PUT-Motorsport/PUTM_EV_Frontbox_2024_Hardware/Hardware/PUTM_EV_Frontbox_2023/PUTM_EV_Frontbox_2023.kicad_pcb

## KiCad design Hardware/PUTM_EV_Frontbox_2023/PUTM_EV_Frontbox_2023.kicad_pcb (2024-03-22)

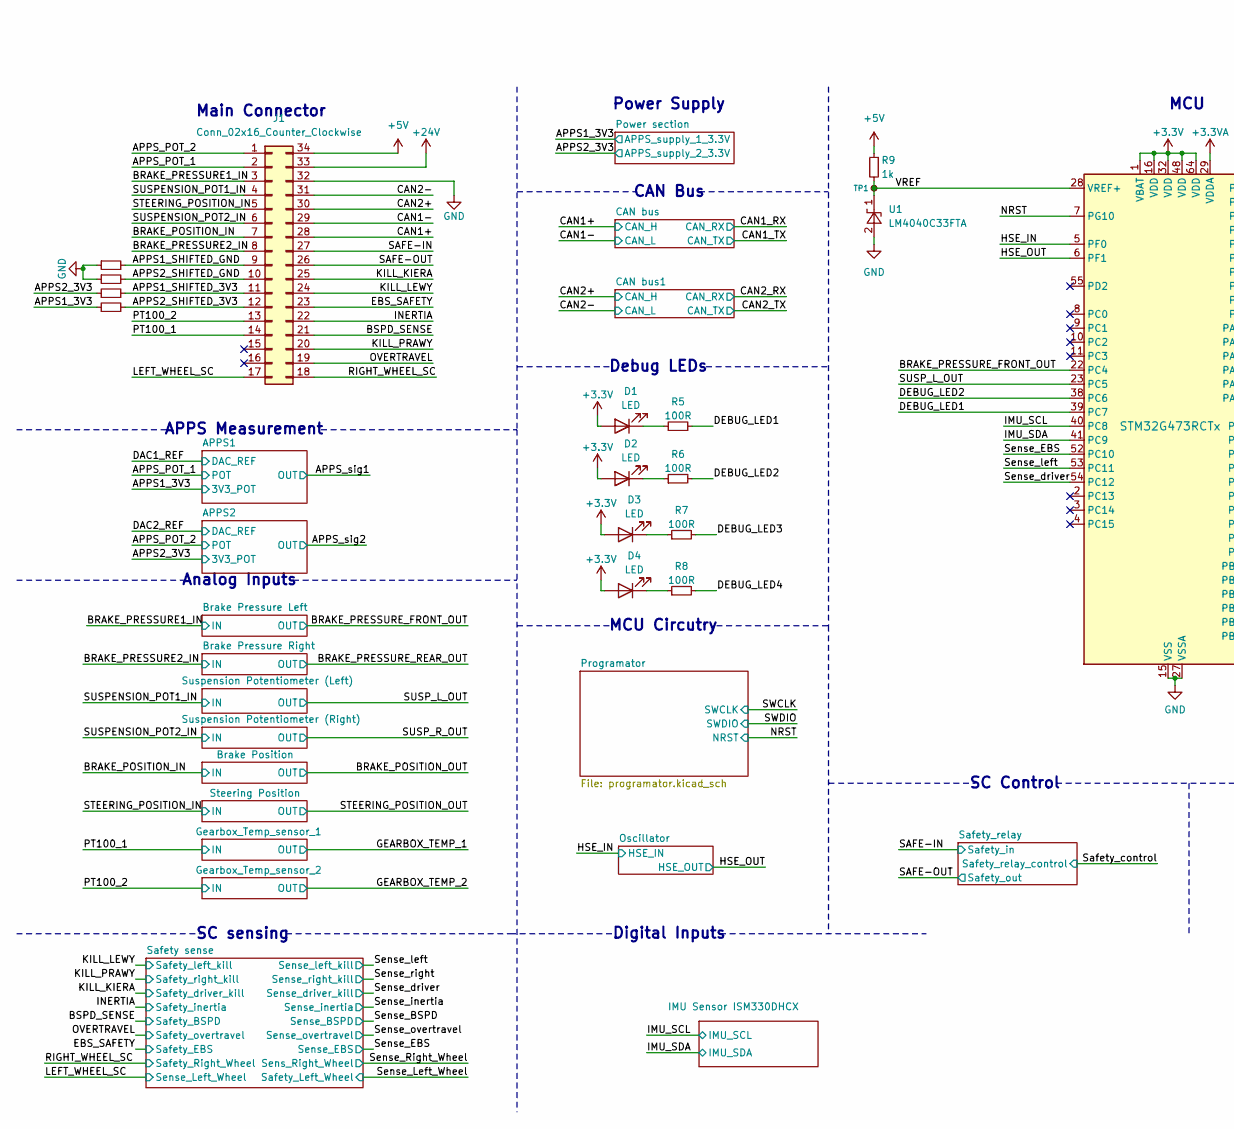
[picture p1: schematic PUTM_EV_Frontbox_2023.kicad_sch, Frontbox, part in row 1, column 1]

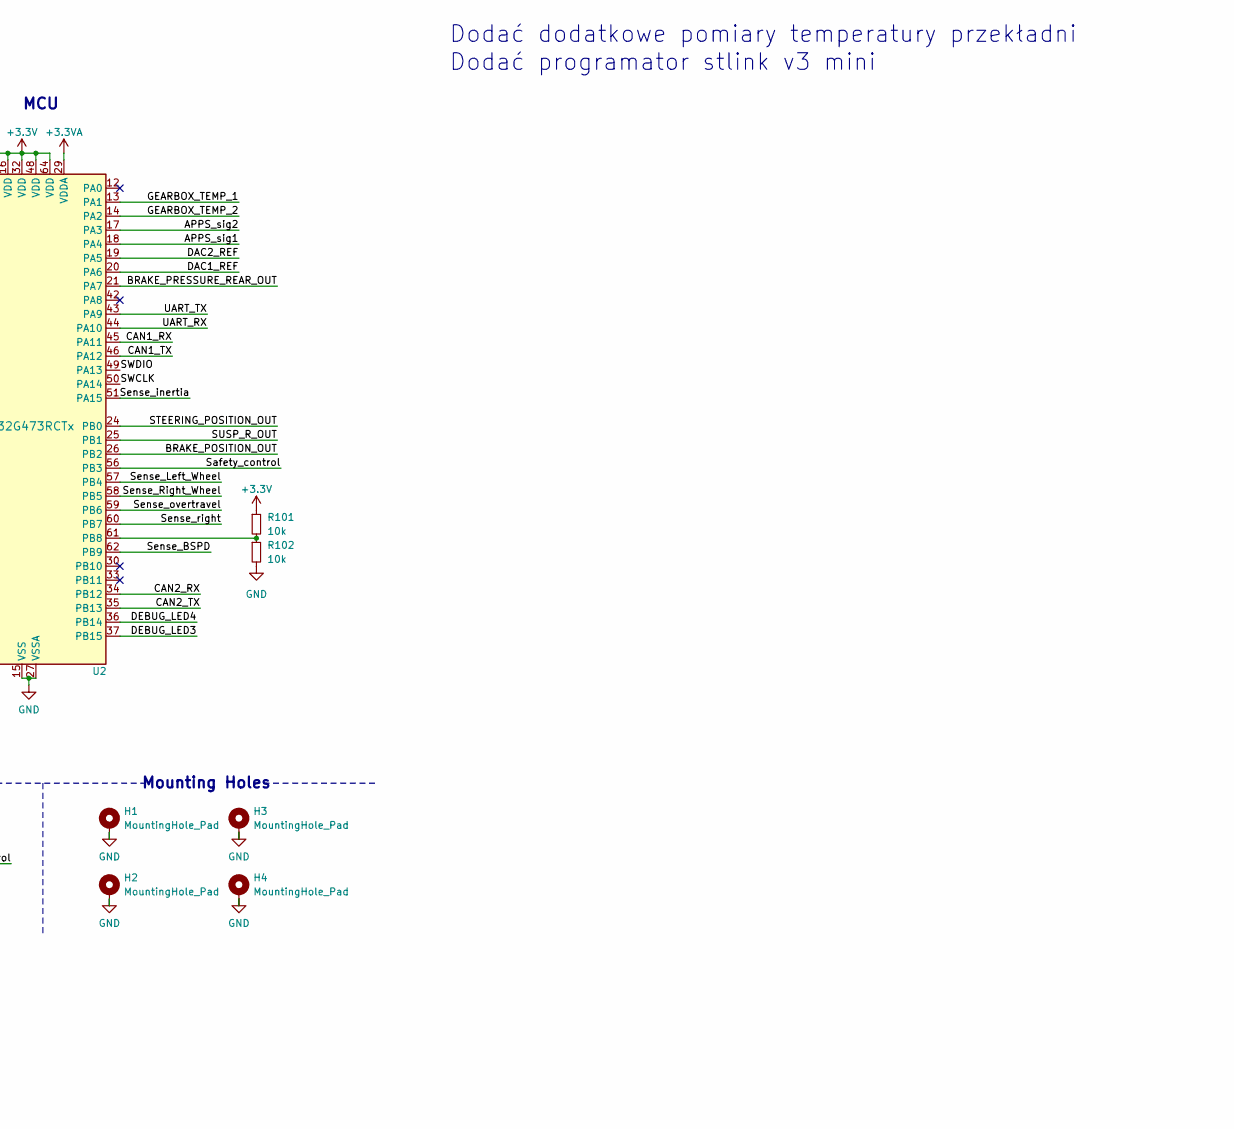
[picture p2: schematic PUTM_EV_Frontbox_2023.kicad_sch, Frontbox, part in row 1, column 2]

Parts:
D1, D2, D3, D4: LED; LED_0603_1608Metric_Pad1.05x0.95mm_HandSolder
H1, H2, H3, H4: MountingHole_Pad; MountingHole_3.2mm_M3_Pad_Via
J1: Conn_02x16_Counter_Clockwise; IDC-Header_2x17-1MP_P2.54mm_Latch6.5mm_Vertical
R1, R2, R3, R4: 220R; R_0603_1608Metric_Pad0.98x0.95mm_HandSolder
R5, R6, R7, R8: 100R; R_0603_1608Metric_Pad0.98x0.95mm_HandSolder
R9: 1k; R_0603_1608Metric
R101, R102: 10k; R_0603_1608Metric
TP1: TestPoint_Small; TestPoint_Pad_D1.0mm
U1: LM4040C33FTA; SOT-23
U2: STM32G473RCTx; LQFP-64_10x10mm_P0.5mm

Connections:
+3.3V: D1.2 (A), D2.2 (A), D3.2 (A), D4.2 (A), R101.1, U2.1 (VBAT), U2.16 (VDD), U2.32 (VDD), U2.48 (VDD), U2.64 (VDD); also elsewhere on the board
+3.3VA: U2.29 (VDDA); also elsewhere on the board
+5V: J1.34, R9.1; also elsewhere on the board
+24V: J1.33; also elsewhere on the board
/APPS1_3V3: R4.1; also elsewhere on the board
/APPS1_SHIFTED_3V3: J1.11, R3.2
/APPS1_SHIFTED_GND: J1.9, R1.2
/APPS2_3V3: R3.1; also elsewhere on the board
/APPS2_SHIFTED_3V3: J1.12, R4.2
/APPS2_SHIFTED_GND: J1.10, R2.2
/APPS_POT_1: J1.2; also elsewhere on the board
/APPS_POT_2: J1.1; also elsewhere on the board
/APPS_sig1: U2.18 (PA4); also elsewhere on the board
/APPS_sig2: U2.17 (PA3); also elsewhere on the board
/BRAKE_POSITION_IN: J1.7; also elsewhere on the board
/BRAKE_POSITION_OUT: U2.26 (PB2); also elsewhere on the board
/BRAKE_PRESSURE1_IN: J1.3; also elsewhere on the board
/BRAKE_PRESSURE2_IN: J1.8; also elsewhere on the board
/BRAKE_PRESSURE_FRONT_OUT: U2.22 (PC4); also elsewhere on the board
/BRAKE_PRESSURE_REAR_OUT: U2.21 (PA7); also elsewhere on the board
/BSPD_SENSE: J1.21; also elsewhere on the board
/CAN1+: J1.28; also elsewhere on the board
/CAN1-: J1.29; also elsewhere on the board
/CAN1_RX: U2.45 (PA11); also elsewhere on the board
/CAN1_TX: U2.46 (PA12); also elsewhere on the board
/CAN2+: J1.30; also elsewhere on the board
/CAN2-: J1.31; also elsewhere on the board
/CAN2_RX: U2.34 (PB12); also elsewhere on the board
/CAN2_TX: U2.35 (PB13); also elsewhere on the board
/DAC1_REF: U2.20 (PA6); also elsewhere on the board
/DAC2_REF: U2.19 (PA5); also elsewhere on the board
/DEBUG_LED1: R5.2, U2.39 (PC7)
/DEBUG_LED2: R6.2, U2.38 (PC6)
/DEBUG_LED3: R7.2, U2.37 (PB15)
/DEBUG_LED4: R8.2, U2.36 (PB14)
/EBS_SAFETY: J1.23; also elsewhere on the board
/GEARBOX_TEMP_1: U2.13 (PA1); also elsewhere on the board
/GEARBOX_TEMP_2: U2.14 (PA2); also elsewhere on the board
/HSE_IN: U2.5 (PF0); also elsewhere on the board
/HSE_OUT: U2.6 (PF1); also elsewhere on the board
/IMU_SCL: U2.40 (PC8); also elsewhere on the board
/IMU_SDA: U2.41 (PC9); also elsewhere on the board
/INERTIA: J1.22; also elsewhere on the board
/KILL_KIERA: J1.25; also elsewhere on the board
/KILL_LEWY: J1.24; also elsewhere on the board
/KILL_PRAWY: J1.20; also elsewhere on the board
/LEFT_WHEEL_SC: J1.17; also elsewhere on the board
/NRST: U2.7 (PG10); also elsewhere on the board
/OVERTRAVEL: J1.19; also elsewhere on the board
/PT100_1: J1.14; also elsewhere on the board
/PT100_2: J1.13; also elsewhere on the board
/RIGHT_WHEEL_SC: J1.18; also elsewhere on the board
/SAFE-IN: J1.27; also elsewhere on the board
/SAFE-OUT: J1.26; also elsewhere on the board
/STEERING_POSITION_IN: J1.5; also elsewhere on the board
/STEERING_POSITION_OUT: U2.24 (PB0); also elsewhere on the board
/SUSPENSION_POT1_IN: J1.4; also elsewhere on the board
/SUSPENSION_POT2_IN: J1.6; also elsewhere on the board
/SUSP_L_OUT: U2.23 (PC5); also elsewhere on the board
/SUSP_R_OUT: U2.25 (PB1); also elsewhere on the board
/SWCLK: U2.50 (PA14); also elsewhere on the board
/SWDIO: U2.49 (PA13); also elsewhere on the board
/Safety_control: U2.56 (PB3); also elsewhere on the board
/Sense_BSPD: U2.62 (PB9); also elsewhere on the board
/Sense_EBS: U2.52 (PC10); also elsewhere on the board
/Sense_Left_Wheel: U2.57 (PB4); also elsewhere on the board
/Sense_Right_Wheel: U2.58 (PB5); also elsewhere on the board
/Sense_driver: U2.54 (PC12); also elsewhere on the board
/Sense_inertia: U2.51 (PA15); also elsewhere on the board
/Sense_left: U2.53 (PC11); also elsewhere on the board
/Sense_overtravel: U2.59 (PB6); also elsewhere on the board
/Sense_right: U2.60 (PB7); also elsewhere on the board
/UART_RX: U2.44 (PA10)
/UART_TX: U2.43 (PA9)
/VREF: R9.2, TP1.1, U1.1 (K), U2.28 (VREF+)
GND: H1.1, H2.1, H3.1, H4.1, J1.32, R1.1, R2.1, R102.2, U1.2 (A), U2.15 (VSS), U2.27 (VSSA), U2.31 (VSS), U2.47 (VSS), U2.63 (VSS); also elsewhere on the board
unnamed: D1.1 (K), R5.1
unnamed: D2.1 (K), R6.1
unnamed: D3.1 (K), R7.1
unnamed: D4.1 (K), R8.1
unnamed: R101.2, R102.1, U2.61 (PB8)

Notes on the sheet:
SC sensing
Dodać programator stlink v3 mini
MCU Circutry
CAN Bus
Debug LEDs
Digital Inputs
Analog Inputs
Main Connector
MCU
Dodać dodatkowe pomiary temperatury przekładni
SC Control
APPS Measurement
Power Supply
Mounting Holes

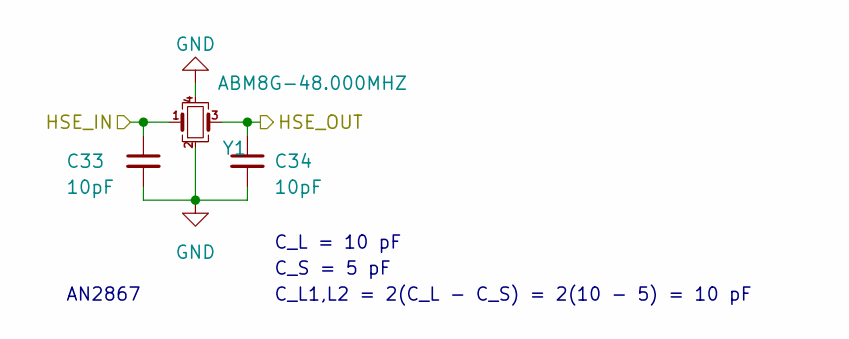
[picture p3: schematic oscillator.kicad_sch]

Parts:
C33, C34: 10pF; C_0402_1005Metric_Pad0.74x0.62mm_HandSolder
Y1: ABM8G-48.000MHZ; Crystal_SMD_Abracon_ABM8G-4Pin_3.2x2.5mm

Connections:
/HSE_IN: C33.1, Y1.1; also elsewhere on the board
/HSE_OUT: C34.1, Y1.3; also elsewhere on the board
GND: C33.2, C34.2, Y1.2, Y1.4; also elsewhere on the board

Notes on the sheet:
C_L = 10 pF
C_S = 5 pF
C_L1,L2 = 2(C_L - C_S) = 2(10 - 5) = 10 pF
AN2867

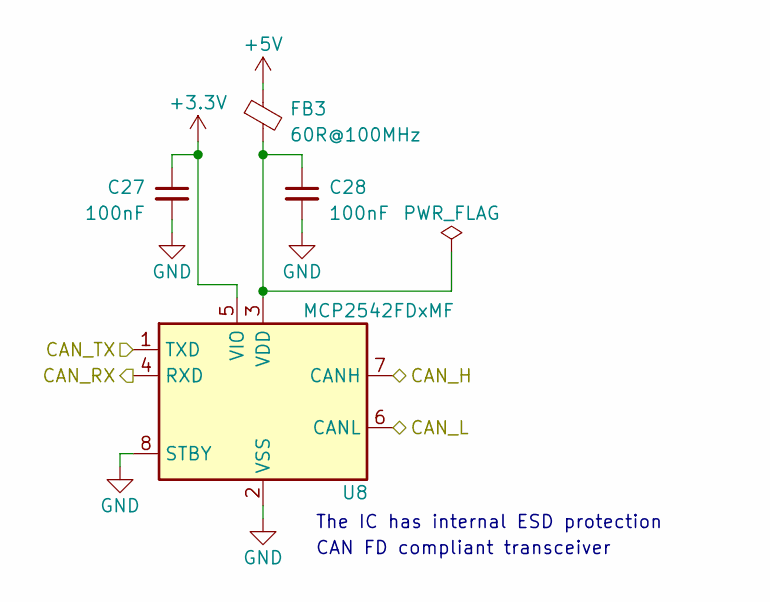
[picture p4: schematic can_bus.kicad_sch, CAN bus]

Parts:
C27, C28: 100nF; C_0402_1005Metric_Pad0.74x0.62mm_HandSolder
FB3: 60R@100MHz; L_0603_1608Metric
U8: MCP2542FDxMF; DFN-8-1EP_3x3mm_P0.65mm_EP1.55x2.4mm

Connections:
+3.3V: C27.1, U8.5 (VIO); also elsewhere on the board
+5V: FB3.1; also elsewhere on the board
/CAN1+: U8.7 (CANH); also elsewhere on the board
/CAN1-: U8.6 (CANL); also elsewhere on the board
/CAN1_RX: U8.4 (RXD); also elsewhere on the board
/CAN1_TX: U8.1 (TXD); also elsewhere on the board
GND: C27.2, C28.2, U8.2 (VSS), U8.8 (STBY), U8.9 (VSS); also elsewhere on the board
unnamed: C28.1, FB3.2, U8.3 (VDD)

Parts of its further copies:
C35, C36: 100nF; C_0402_1005Metric_Pad0.74x0.62mm_HandSolder
FB4: 60R@100MHz; L_0603_1608Metric
U14: MCP2542FDxMF; DFN-8-1EP_3x3mm_P0.65mm_EP1.55x2.4mm

Connections of its further copies:
+3.3V: C35.1, U14.5 (VIO); also elsewhere on the board
+5V: FB4.1; also elsewhere on the board
/CAN2+: U14.7 (CANH); also elsewhere on the board
/CAN2-: U14.6 (CANL); also elsewhere on the board
/CAN2_RX: U14.4 (RXD); also elsewhere on the board
/CAN2_TX: U14.1 (TXD); also elsewhere on the board
GND: C35.2, C36.2, U14.2 (VSS), U14.8 (STBY), U14.9 (VSS); also elsewhere on the board
unnamed: C36.1, FB4.2, U14.3 (VDD)

Notes on the sheet:
The IC has internal ESD protection
CAN FD compliant transceiver

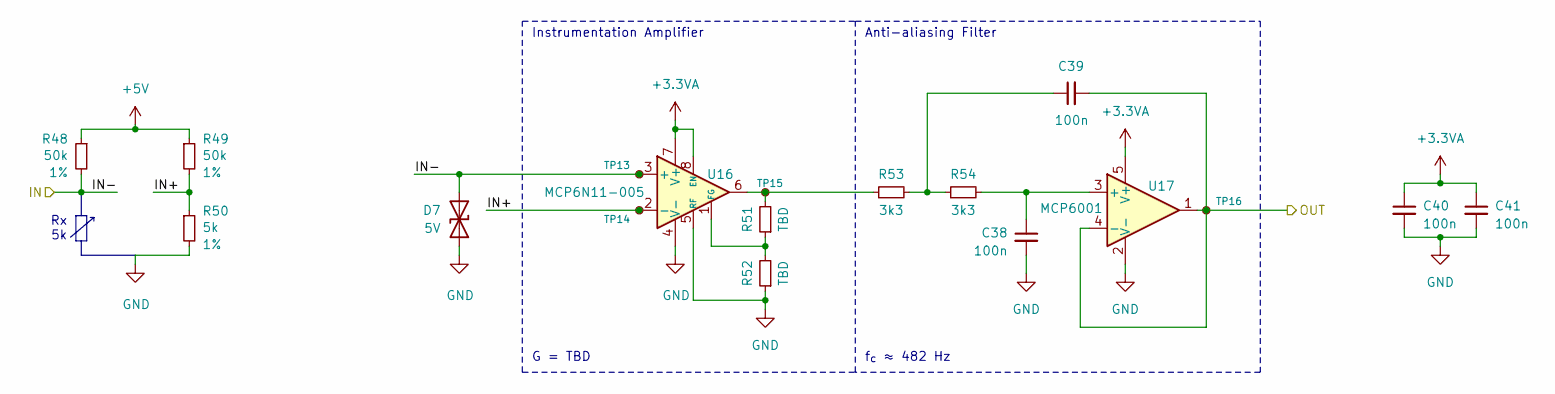
[picture p5: schematic suspension_potentiometer.kicad_sch]

Parts:
C38, C39, C40: 100n; C_0603_1608Metric
C41: 100n; C_0402_1005Metric_Pad0.74x0.62mm_HandSolder
D7: 5V; D_SOD-523
R48, R49: 50k; R_0603_1608Metric; Tolerance 1%
R50: 5k; R_0603_1608Metric; Tolerance 1%
R51, R52: TBD; R_0603_1608Metric
R53, R54: 3k3; R_0603_1608Metric
TP13, TP14, TP15, TP16: TestPoint_Small; TestPoint_Pad_D1.0mm
U16: MCP6N11-005; TDFN-8-1EP_3x2mm_P0.5mm_EP1.80x1.65mm
U17: MCP6001; SOT-23-5

Connections:
+3.3VA: C40.1, C41.1, U16.7 (V+), U16.8 (EN), U17.5 (V+); also elsewhere on the board
+5V: R48.1, R49.1; also elsewhere on the board
/SUSPENSION_POT1_IN: D7.2 (A2), R48.2, TP13.1, U16.3 (+); also elsewhere on the board
/SUSP_L_OUT: C39.2, TP16.1, U17.1, U17.4 (-); also elsewhere on the board
/Suspension Potentiometer (Left)/IN+: R49.2, R50.1, TP14.1, U16.2 (-)
GND: C38.2, C40.2, C41.2, D7.1 (A1), R50.2, R52.1, U16.4 (V-), U16.5 (RF), U16.9 (EP), U17.2 (V-); also elsewhere on the board
unnamed: C39.1, R53.2, R54.1
unnamed: R51.2, R53.1, TP15.1, U16.6
unnamed: R51.1, R52.2, U16.1 (FG)
unnamed: C38.1, R54.2, U17.3 (+)

Parts of its further copies:
C29, C30, C31, C53, C54, C55, C57, C58, C59, C61, C62, C63, C65, C66, C67: 100n; C_0603_1608Metric
C32, C56, C60, C64, C68: 100n; C_0402_1005Metric_Pad0.74x0.62mm_HandSolder
D5, D10, D11, D12, D13: 5V; D_SOD-523
R15, R16, R73, R74, R80, R81, R87, R88, R94, R95: 50k; R_0603_1608Metric; Tolerance 1%
R17, R75, R82, R89, R96: 5k; R_0603_1608Metric; Tolerance 1%
R18, R19, R76, R77, R83, R84, R90, R91, R97, R98: TBD; R_0603_1608Metric
R20, R21, R78, R79, R85, R86, R92, R93, R99, R100: 3k3; R_0603_1608Metric
TP5, TP6, TP7, TP8, TP29, TP30, TP31, TP32, TP33, TP34, TP35, TP36, TP37, TP38, TP39, TP40, TP41, TP42, TP43, TP44: TestPoint_Small; TestPoint_Pad_D1.0mm
U9, U23, U25, U27, U29: MCP6N11-005; TDFN-8-1EP_3x2mm_P0.5mm_EP1.80x1.65mm
U10, U24, U26, U28, U30: MCP6001; SOT-23-5

Connections of its further copies:
+3.3VA: C31.1, C32.1, C55.1, C56.1, C59.1, C60.1, C63.1, C64.1, C67.1, C68.1, U9.7 (V+), U9.8 (EN), U10.5 (V+), U23.7 (V+), U23.8 (EN), U24.5 (V+), U25.7 (V+), U25.8 (EN), U26.5 (V+), U27.7 (V+), U27.8 (EN), U28.5 (V+), U29.7 (V+), U29.8 (EN), U30.5 (V+); also elsewhere on the board
+5V: R15.1, R16.1, R73.1, R74.1, R80.1, R81.1, R87.1, R88.1, R94.1, R95.1; also elsewhere on the board
/BRAKE_POSITION_IN: D5.2 (A2), R15.2, TP5.1, U9.3 (+); also elsewhere on the board
/BRAKE_POSITION_OUT: C30.2, TP8.1, U10.1, U10.4 (-); also elsewhere on the board
/Brake Position/IN+: R16.2, R17.1, TP6.1, U9.2 (-)
/GEARBOX_TEMP_1: C62.2, TP40.1, U28.1, U28.4 (-); also elsewhere on the board
/GEARBOX_TEMP_2: C66.2, TP44.1, U30.1, U30.4 (-); also elsewhere on the board
/Gearbox_Temp_sensor_1/IN+: R88.2, R89.1, TP38.1, U27.2 (-)
/Gearbox_Temp_sensor_2/IN+: R95.2, R96.1, TP42.1, U29.2 (-)
/PT100_1: D12.2 (A2), R87.2, TP37.1, U27.3 (+); also elsewhere on the board
/PT100_2: D13.2 (A2), R94.2, TP41.1, U29.3 (+); also elsewhere on the board
/STEERING_POSITION_IN: D10.2 (A2), R73.2, TP29.1, U23.3 (+); also elsewhere on the board
/STEERING_POSITION_OUT: C54.2, TP32.1, U24.1, U24.4 (-); also elsewhere on the board
/SUSPENSION_POT2_IN: D11.2 (A2), R80.2, TP33.1, U25.3 (+); also elsewhere on the board
/SUSP_R_OUT: C58.2, TP36.1, U26.1, U26.4 (-); also elsewhere on the board
/Steering Position/IN+: R74.2, R75.1, TP30.1, U23.2 (-)
/Suspension Potentiometer (Right)/IN+: R81.2, R82.1, TP34.1, U25.2 (-)
GND: C29.2, C31.2, C32.2, C53.2, C55.2, C56.2, C57.2, C59.2, C60.2, C61.2, C63.2, C64.2, C65.2, C67.2, C68.2, D5.1 (A1), D10.1 (A1), D11.1 (A1), D12.1 (A1), D13.1 (A1), R17.2, R19.1, R75.2, R77.1, R82.2, R84.1, R89.2, R91.1, R96.2, R98.1, U9.4 (V-), U9.5 (RF), U9.9 (EP), U10.2 (V-), U23.4 (V-), U23.5 (RF), U23.9 (EP), U24.2 (V-), U25.4 (V-), U25.5 (RF), U25.9 (EP), U26.2 (V-), U27.4 (V-), U27.5 (RF), U27.9 (EP), U28.2 (V-), U29.4 (V-), U29.5 (RF), U29.9 (EP), U30.2 (V-); also elsewhere on the board
unnamed: C30.1, R20.2, R21.1
unnamed: C54.1, R78.2, R79.1
unnamed: C58.1, R85.2, R86.1
unnamed: C62.1, R92.2, R93.1
unnamed: C66.1, R99.2, R100.1
unnamed: R18.2, R20.1, TP7.1, U9.6
unnamed: R76.2, R78.1, TP31.1, U23.6
unnamed: R83.2, R85.1, TP35.1, U25.6
unnamed: R90.2, R92.1, TP39.1, U27.6
unnamed: R97.2, R99.1, TP43.1, U29.6
unnamed: R18.1, R19.2, U9.1 (FG)
unnamed: C29.1, R21.2, U10.3 (+)
unnamed: R76.1, R77.2, U23.1 (FG)
unnamed: C53.1, R79.2, U24.3 (+)
unnamed: R83.1, R84.2, U25.1 (FG)
unnamed: C57.1, R86.2, U26.3 (+)
unnamed: R90.1, R91.2, U27.1 (FG)
unnamed: C61.1, R93.2, U28.3 (+)
unnamed: R97.1, R98.2, U29.1 (FG)
unnamed: C65.1, R100.2, U30.3 (+)

Notes on the sheet:
G = TBD
f_{c} ≈ 482 Hz
Instrumentation Amplifier
Rx 5k
Anti-aliasing Filter

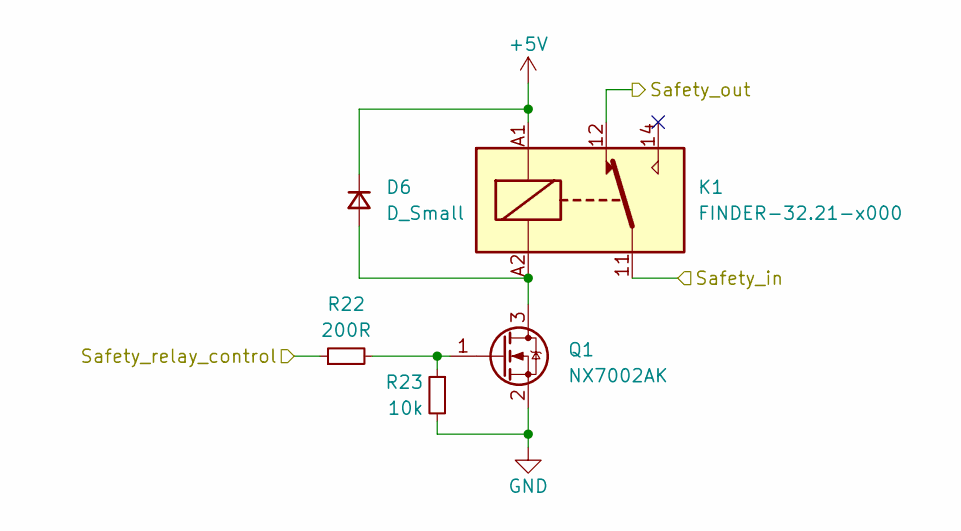
[picture p6: schematic safety_relay.kicad_sch, Safety relay control]

Parts:
D6: D_Small; D_0805_2012Metric_Pad1.15x1.40mm_HandSolder
K1: FINDER-32.21-x000; Relay_SPDT_Finder_32.21-x000
Q1: NX7002AK; SOT-23
R22: 200R; R_0402_1005Metric
R23: 10k; R_0402_1005Metric

Connections:
+5V: D6.1 (K), K1.A1; also elsewhere on the board
/SAFE-IN: K1.11; also elsewhere on the board
/SAFE-OUT: K1.12; also elsewhere on the board
/Safety_control: R22.1; also elsewhere on the board
GND: Q1.2 (S), R23.2; also elsewhere on the board
unnamed: D6.2 (A), K1.A2, Q1.3 (D)
unnamed: Q1.1 (G), R22.2, R23.1

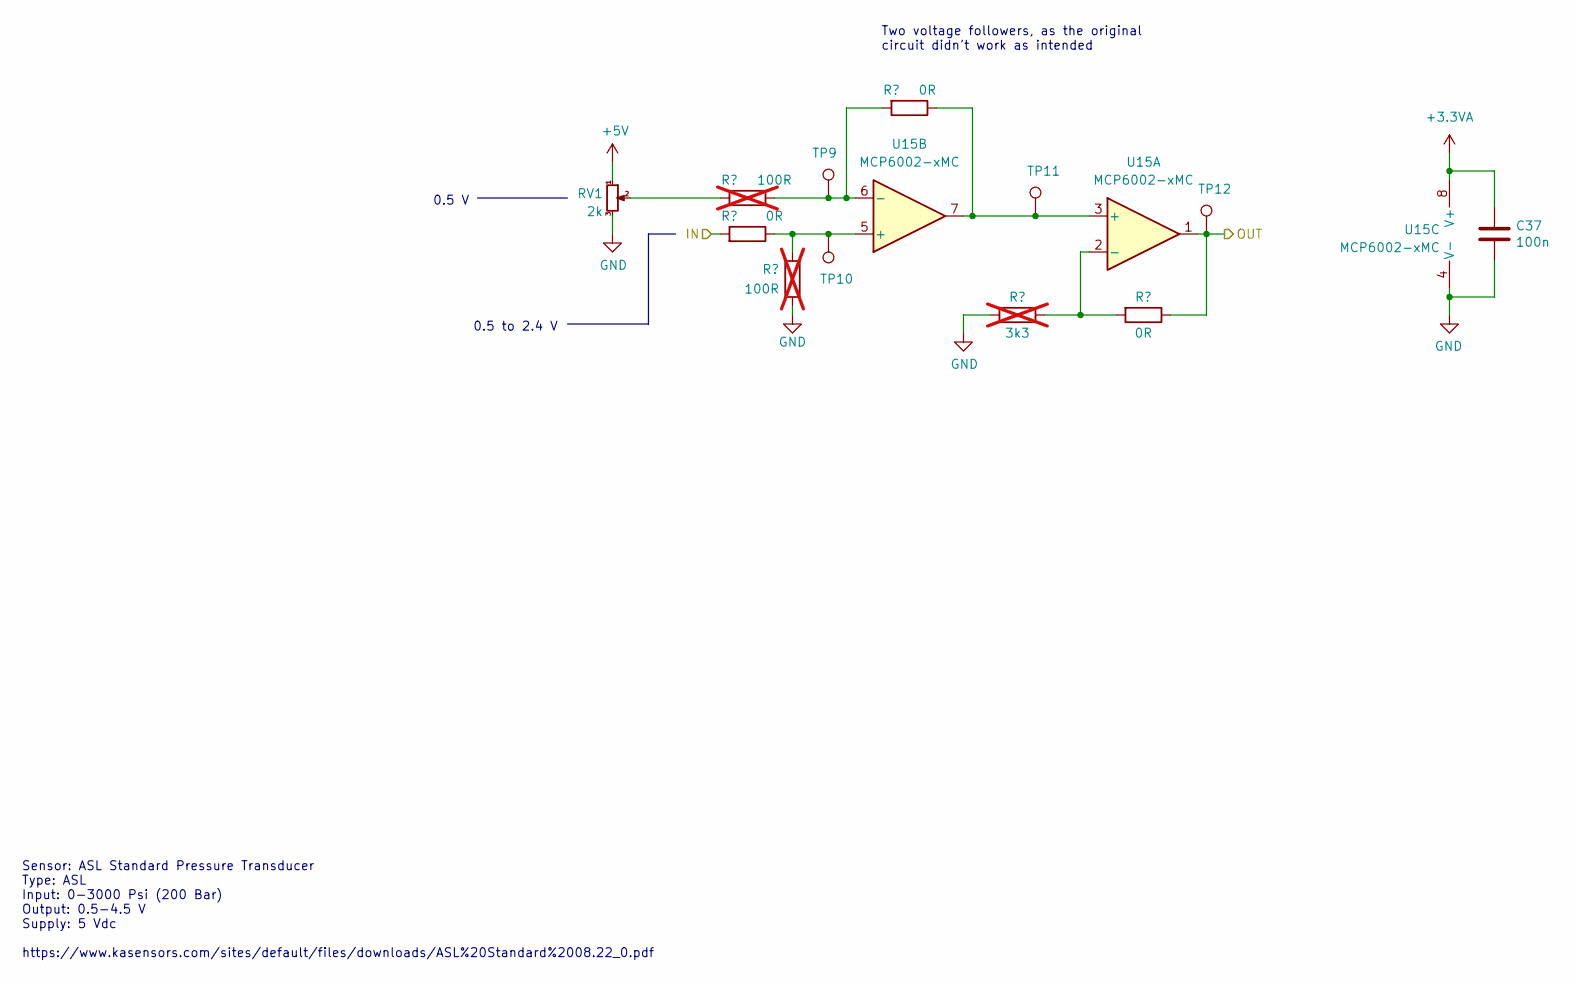
[picture p7: schematic brake_pressure.kicad_sch, Brake pressure]

Parts:
C37: 100n; C_0603_1608Metric_Pad1.08x0.95mm_HandSolder
R42, R44: 100R; R_0603_1608Metric_Pad0.98x0.95mm_HandSolder; not fitted
R43, R45, R47: 0R; R_0603_1608Metric_Pad0.98x0.95mm_HandSolder
R46: 3k3; R_0603_1608Metric_Pad0.98x0.95mm_HandSolder; not fitted
RV1: 2k; Potentiometer_Bourns_3214J_Horizontal
TP9: BR_N; TestPoint_Pad_D1.0mm
TP10: BR_P; TestPoint_Pad_D1.0mm
TP11: BR_MID; TestPoint_Pad_D1.0mm
TP12: BR_OUT; TestPoint_Pad_D1.0mm
U15: MCP6002-xMC; DFN-8-1EP_3x2mm_P0.5mm_EP1.7x1.4mm

Connections:
+3.3VA: C37.1, U15.8 (V+); also elsewhere on the board
+5V: RV1.1; also elsewhere on the board
/BRAKE_PRESSURE1_IN: R43.2; also elsewhere on the board
/BRAKE_PRESSURE_FRONT_OUT: R47.1, TP12.1, U15.1; also elsewhere on the board
GND: C37.2, R44.1, R46.2, RV1.3, U15.4 (V-), U15.9 (V-); also elsewhere on the board
unnamed: R42.2, RV1.2
unnamed: R45.1, TP11.1, U15.3 (+), U15.7
unnamed: R46.1, R47.2, U15.2 (-)
unnamed: R43.1, R44.2, TP10.1, U15.5 (+)
unnamed: R42.1, R45.2, TP9.1, U15.6 (-)

Parts of its further copies:
C42: 100n; C_0603_1608Metric_Pad1.08x0.95mm_HandSolder
R55, R57: 100R; R_0603_1608Metric_Pad0.98x0.95mm_HandSolder; not fitted
R56, R58, R60: 0R; R_0603_1608Metric_Pad0.98x0.95mm_HandSolder
R59: 3k3; R_0603_1608Metric_Pad0.98x0.95mm_HandSolder; not fitted
RV2: 2k; Potentiometer_Bourns_3214J_Horizontal
TP17: BR_N; TestPoint_Pad_D1.0mm
TP18: BR_P; TestPoint_Pad_D1.0mm
TP19: BR_MID; TestPoint_Pad_D1.0mm
TP20: BR_OUT; TestPoint_Pad_D1.0mm
U18: MCP6002-xMC; DFN-8-1EP_3x2mm_P0.5mm_EP1.7x1.4mm

Connections of its further copies:
+3.3VA: C42.1, U18.8 (V+); also elsewhere on the board
+5V: RV2.1; also elsewhere on the board
/BRAKE_PRESSURE2_IN: R56.2; also elsewhere on the board
/BRAKE_PRESSURE_REAR_OUT: R60.1, TP20.1, U18.1; also elsewhere on the board
GND: C42.2, R57.1, R59.2, RV2.3, U18.4 (V-), U18.9 (V-); also elsewhere on the board
unnamed: R55.2, RV2.2
unnamed: R58.1, TP19.1, U18.3 (+), U18.7
unnamed: R59.1, R60.2, U18.2 (-)
unnamed: R56.1, R57.2, TP18.1, U18.5 (+)
unnamed: R55.1, R58.2, TP17.1, U18.6 (-)

Notes on the sheet:
Sensor: ASL Standard Pressure Transducer Type: ASL Input: 0-3000 Psi (200 Bar) Output: 0.5-4.5 V Supply: 5 Vdc https://www.kasensors.com/sites/default/files/downloads/ASL%20Standard%2008.22_0.pdf
Two voltage followers, as the original circuit didn't work as intended
0.5 to 2.4 V
0.5 V

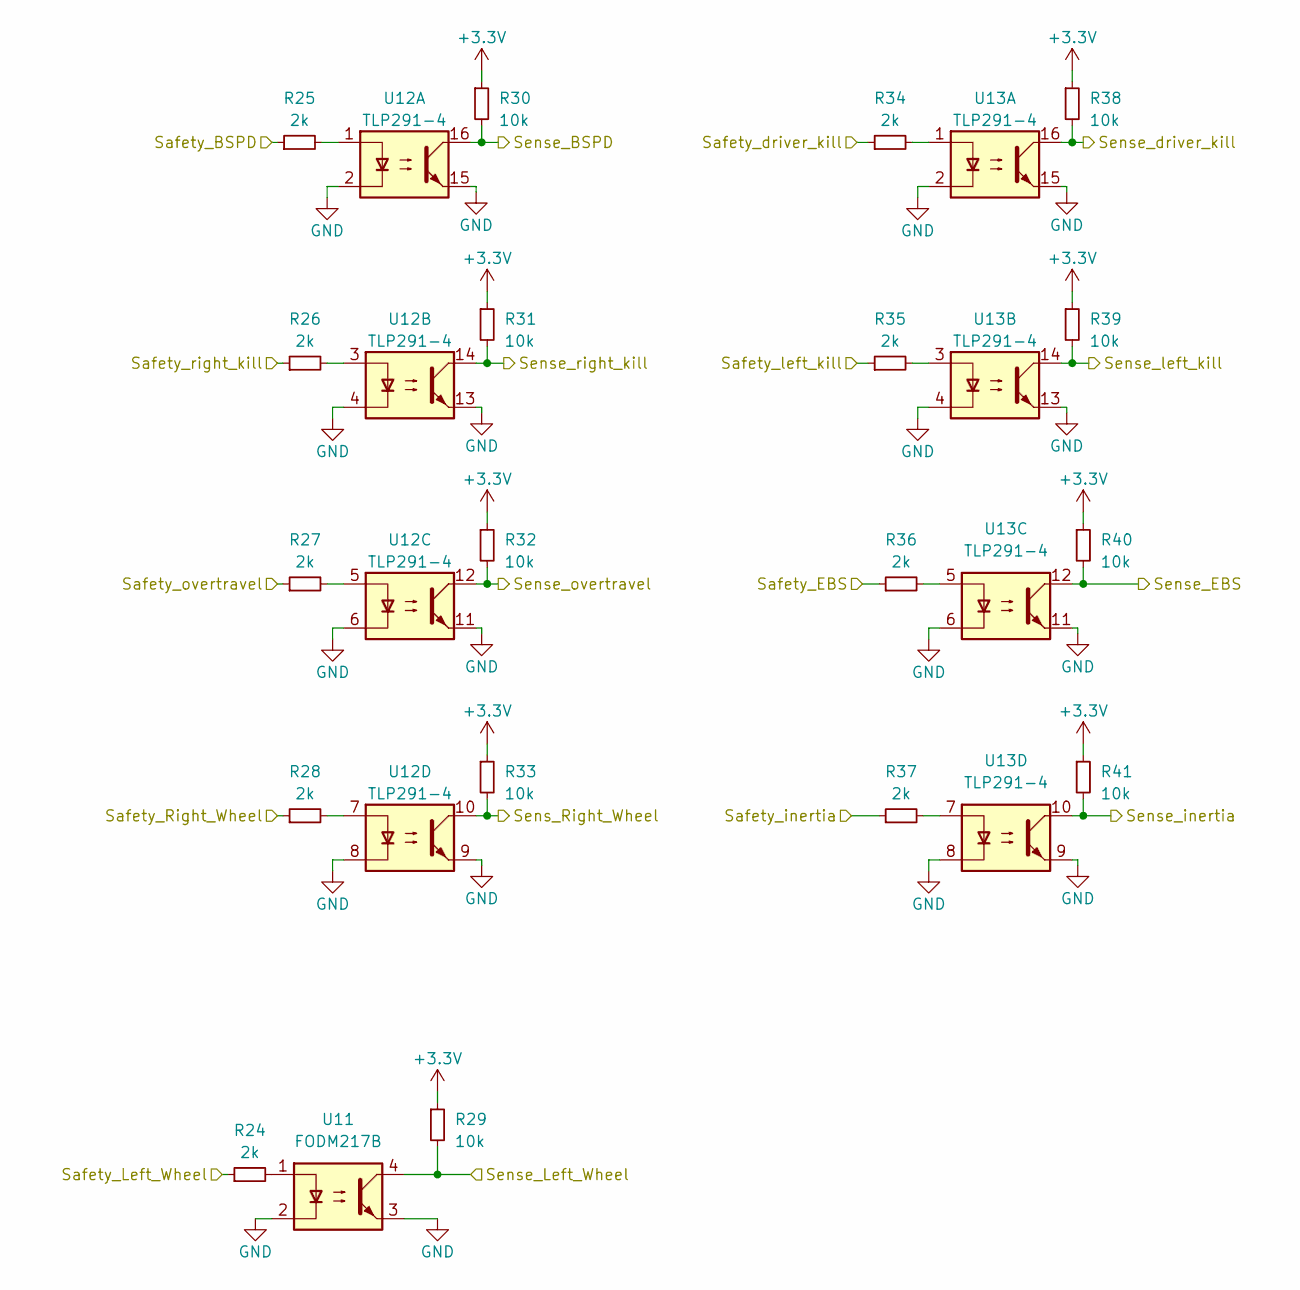
[picture p8: schematic safety_sense.kicad_sch, Safety sense]

Parts:
R24, R25, R26, R27, R28, R34, R35, R36, R37: 2k; R_0402_1005Metric
R29, R30, R31, R32, R33, R38, R39, R40, R41: 10k; R_0402_1005Metric
U11: FODM217B; SOP-4_4.4x2.6mm_P1.27mm
U12, U13: TLP291-4; SOIC-16_4.55x10.3mm_P1.27mm

Connections:
+3.3V: R29.1, R30.1, R31.1, R32.1, R33.1, R38.1, R39.1, R40.1, R41.1; also elsewhere on the board
/BSPD_SENSE: R25.1; also elsewhere on the board
/EBS_SAFETY: R36.1; also elsewhere on the board
/INERTIA: R37.1; also elsewhere on the board
/KILL_KIERA: R34.1; also elsewhere on the board
/KILL_LEWY: R35.1; also elsewhere on the board
/KILL_PRAWY: R26.1; also elsewhere on the board
/LEFT_WHEEL_SC: R29.2, U11.4; also elsewhere on the board
/OVERTRAVEL: R27.1; also elsewhere on the board
/RIGHT_WHEEL_SC: R28.1; also elsewhere on the board
/Sense_BSPD: R30.2, U12.16; also elsewhere on the board
/Sense_EBS: R40.2, U13.12; also elsewhere on the board
/Sense_Left_Wheel: R24.1; also elsewhere on the board
/Sense_Right_Wheel: R33.2, U12.10; also elsewhere on the board
/Sense_driver: R38.2, U13.16; also elsewhere on the board
/Sense_inertia: R41.2, U13.10; also elsewhere on the board
/Sense_left: R39.2, U13.14; also elsewhere on the board
/Sense_overtravel: R32.2, U12.12; also elsewhere on the board
/Sense_right: R31.2, U12.14; also elsewhere on the board
GND: U11.2, U11.3, U12.2, U12.4, U12.6, U12.8, U12.9, U12.11, U12.13, U12.15, U13.2, U13.4, U13.6, U13.8, U13.9, U13.11, U13.13, U13.15; also elsewhere on the board
unnamed: R24.2, U11.1
unnamed: R25.2, U12.1
unnamed: R26.2, U12.3
unnamed: R27.2, U12.5
unnamed: R28.2, U12.7
unnamed: R34.2, U13.1
unnamed: R35.2, U13.3
unnamed: R36.2, U13.5
unnamed: R37.2, U13.7

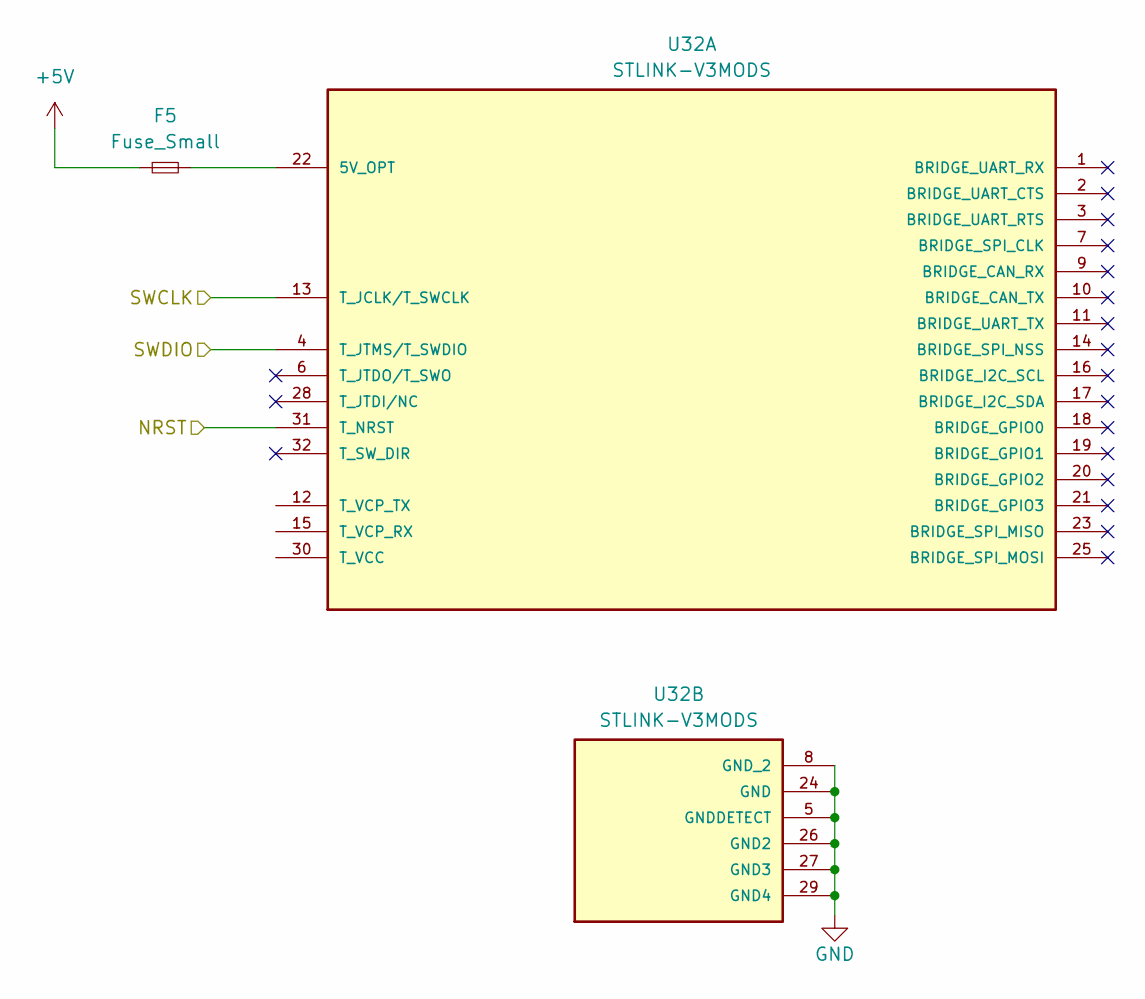
[picture p9: schematic programator.kicad_sch]

Parts:
F5: Fuse_Small; Fuse_0805_2012Metric
U32: STLINK-V3MODS; MODULE_STLINK-V3MODS; PARTREV 1; DigiKey_Part_Number 497-STLINK-V3MODS-ND

Connections:
+5V: F5.1; also elsewhere on the board
/NRST: U32.31 (T_NRST); also elsewhere on the board
/SWCLK: U32.13 (T_JCLK/T_SWCLK); also elsewhere on the board
/SWDIO: U32.4 (T_JTMS/T_SWDIO); also elsewhere on the board
GND: U32.5 (GNDDETECT), U32.8 (GND_2), U32.24 (GND), U32.26 (GND2), U32.27 (GND3), U32.29 (GND4); also elsewhere on the board
unnamed: F5.2, U32.22 (5V_OPT)

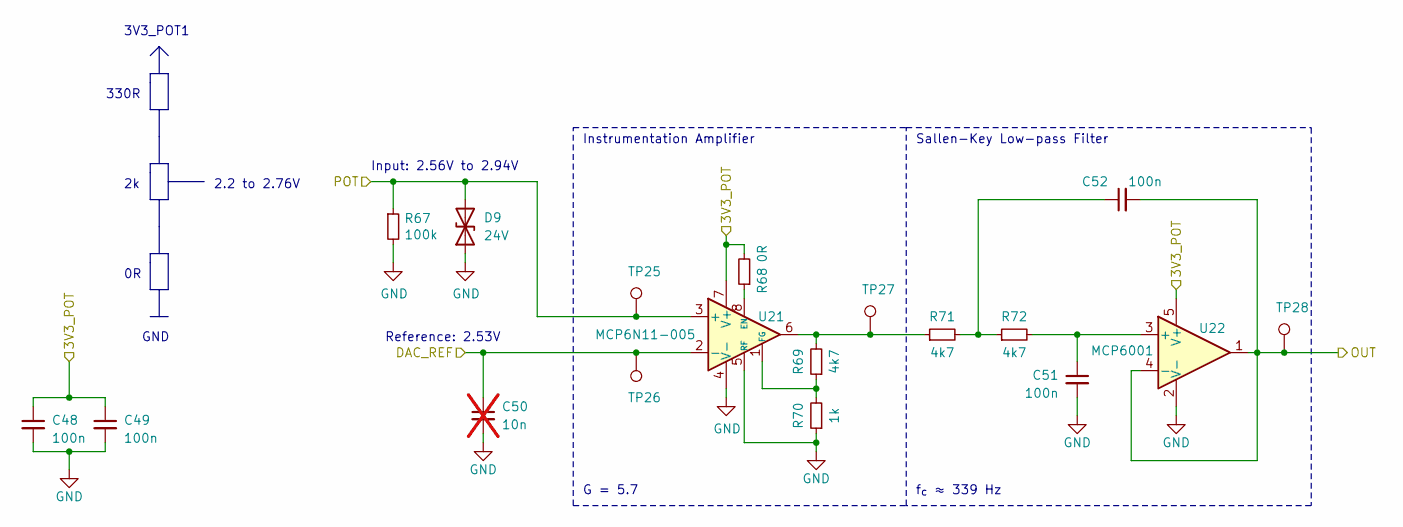
[picture p10: schematic APPS1.kicad_sch]

Parts:
C48, C49, C51, C52: 100n; C_0603_1608Metric_Pad1.08x0.95mm_HandSolder
C50: 10n; C_0603_1608Metric_Pad1.08x0.95mm_HandSolder; not fitted
D9: 24V; D_0603_1608Metric_Pad1.05x0.95mm_HandSolder
R67: 100k; R_0603_1608Metric_Pad0.98x0.95mm_HandSolder
R68: 0R; R_0603_1608Metric_Pad0.98x0.95mm_HandSolder
R69, R71, R72: 4k7; R_0603_1608Metric_Pad0.98x0.95mm_HandSolder
R70: 1k; R_0603_1608Metric_Pad0.98x0.95mm_HandSolder
TP25: APPS_P; TestPoint_Pad_D1.0mm
TP26: APPS_N; TestPoint_Pad_D1.0mm
TP27: APPS_MID; TestPoint_Pad_D1.0mm
TP28: APPS_OUT; TestPoint_Pad_D1.0mm
U21: MCP6N11-005; TDFN-8-1EP_3x2mm_P0.5mm_EP1.3x1.4mm
U22: MCP6001; SOT-23-5

Connections:
/APPS1_3V3: C48.1, C49.1, R68.2, U21.7 (V+), U22.5 (V+); also elsewhere on the board
/APPS_POT_1: D9.2 (A2), R67.1, TP25.1, U21.3 (+); also elsewhere on the board
/APPS_sig1: C52.2, TP28.1, U22.1, U22.4 (-); also elsewhere on the board
/DAC1_REF: C50.1, TP26.1, U21.2 (-); also elsewhere on the board
GND: C48.2, C49.2, C50.2, C51.2, D9.1 (A1), R67.2, R70.1, U21.4 (V-), U21.5 (RF), U21.9 (EP), U22.2 (V-); also elsewhere on the board
unnamed: C52.1, R71.2, R72.1
unnamed: R69.2, R71.1, TP27.1, U21.6
unnamed: R68.1, U21.8 (EN)
unnamed: R69.1, R70.2, U21.1 (FG)
unnamed: C51.1, R72.2, U22.3 (+)

Parts of its further copies:
C43, C44, C46, C47: 100n; C_0603_1608Metric_Pad1.08x0.95mm_HandSolder
C45: 10n; C_0603_1608Metric_Pad1.08x0.95mm_HandSolder; not fitted
D8: 24V; D_0603_1608Metric_Pad1.05x0.95mm_HandSolder
R61: 100k; R_0603_1608Metric_Pad0.98x0.95mm_HandSolder
R62: 0R; R_0603_1608Metric_Pad0.98x0.95mm_HandSolder
R63, R65, R66: 4k7; R_0603_1608Metric_Pad0.98x0.95mm_HandSolder
R64: 1k; R_0603_1608Metric_Pad0.98x0.95mm_HandSolder
TP21: APPS_P; TestPoint_Pad_D1.0mm
TP22: APPS_N; TestPoint_Pad_D1.0mm
TP23: APPS_MID; TestPoint_Pad_D1.0mm
TP24: APPS_OUT; TestPoint_Pad_D1.0mm
U19: MCP6N11-005; TDFN-8-1EP_3x2mm_P0.5mm_EP1.3x1.4mm
U20: MCP6001; SOT-23-5

Connections of its further copies:
/APPS2_3V3: C43.1, C44.1, R62.2, U19.7 (V+), U20.5 (V+); also elsewhere on the board
/APPS_POT_2: D8.2 (A2), R61.1, TP21.1, U19.3 (+); also elsewhere on the board
/APPS_sig2: C47.2, TP24.1, U20.1, U20.4 (-); also elsewhere on the board
/DAC2_REF: C45.1, TP22.1, U19.2 (-); also elsewhere on the board
GND: C43.2, C44.2, C45.2, C46.2, D8.1 (A1), R61.2, R64.1, U19.4 (V-), U19.5 (RF), U19.9 (EP), U20.2 (V-); also elsewhere on the board
unnamed: C47.1, R65.2, R66.1
unnamed: R63.2, R65.1, TP23.1, U19.6
unnamed: R62.1, U19.8 (EN)
unnamed: R63.1, R64.2, U19.1 (FG)
unnamed: C46.1, R66.2, U20.3 (+)

Notes on the sheet:
330R
Instrumentation Amplifier
Input: 2.56V to 2.94V
Sallen-Key Low-pass Filter
2.2 to 2.76V
Reference: 2.53V
f_{c} ≈ 339 Hz
G = 5.7
3V3_POT1
GND

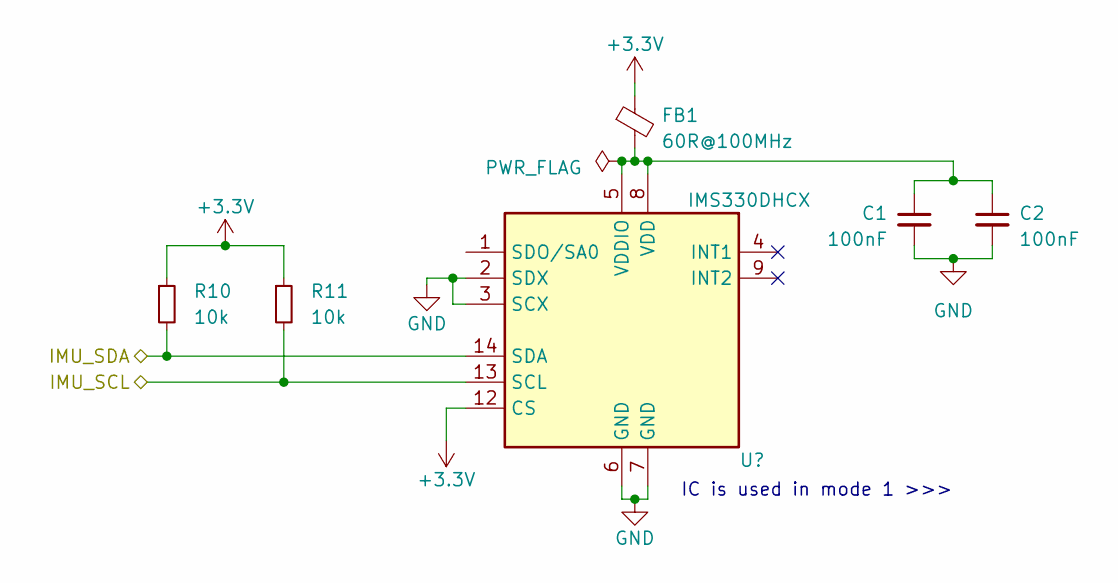
[picture p11: schematic imu_sensor.kicad_sch, IMU and SWPS sensor]

Parts:
C1, C2: 100nF; C_0402_1005Metric_Pad0.74x0.62mm_HandSolder
FB1: 60R@100MHz; L_0603_1608Metric
R10, R11: 10k; R_0603_1608Metric_Pad0.98x0.95mm_HandSolder
U3: IMS330DHCX; LGA-14_3x2.5mm_P0.5mm_LayoutBorder3x4y

Connections:
+3.3V: FB1.1, R10.1, R11.1, U3.12 (CS); also elsewhere on the board
/IMU_SCL: R11.2, U3.13 (SCL); also elsewhere on the board
/IMU_SDA: R10.2, U3.14 (SDA); also elsewhere on the board
GND: C1.2, C2.2, U3.2 (SDX), U3.3 (SCX), U3.6 (GND), U3.7 (GND); also elsewhere on the board
unnamed: C1.1, C2.1, FB1.2, U3.5 (VDDIO), U3.8 (VDD)

Notes on the sheet:
IC is used in mode 1 >>>
