PUT-Motorsport/PUTM_EV_Frontbox_2024_Hardware/Hardware/PUTM_EV_Frontbox_2023/PUTM_EV_Frontbox_2023.kicad_pcb

## KiCad design Hardware/PUTM_EV_Frontbox_2023/PUTM_EV_Frontbox_2023.kicad_pcb (continued)

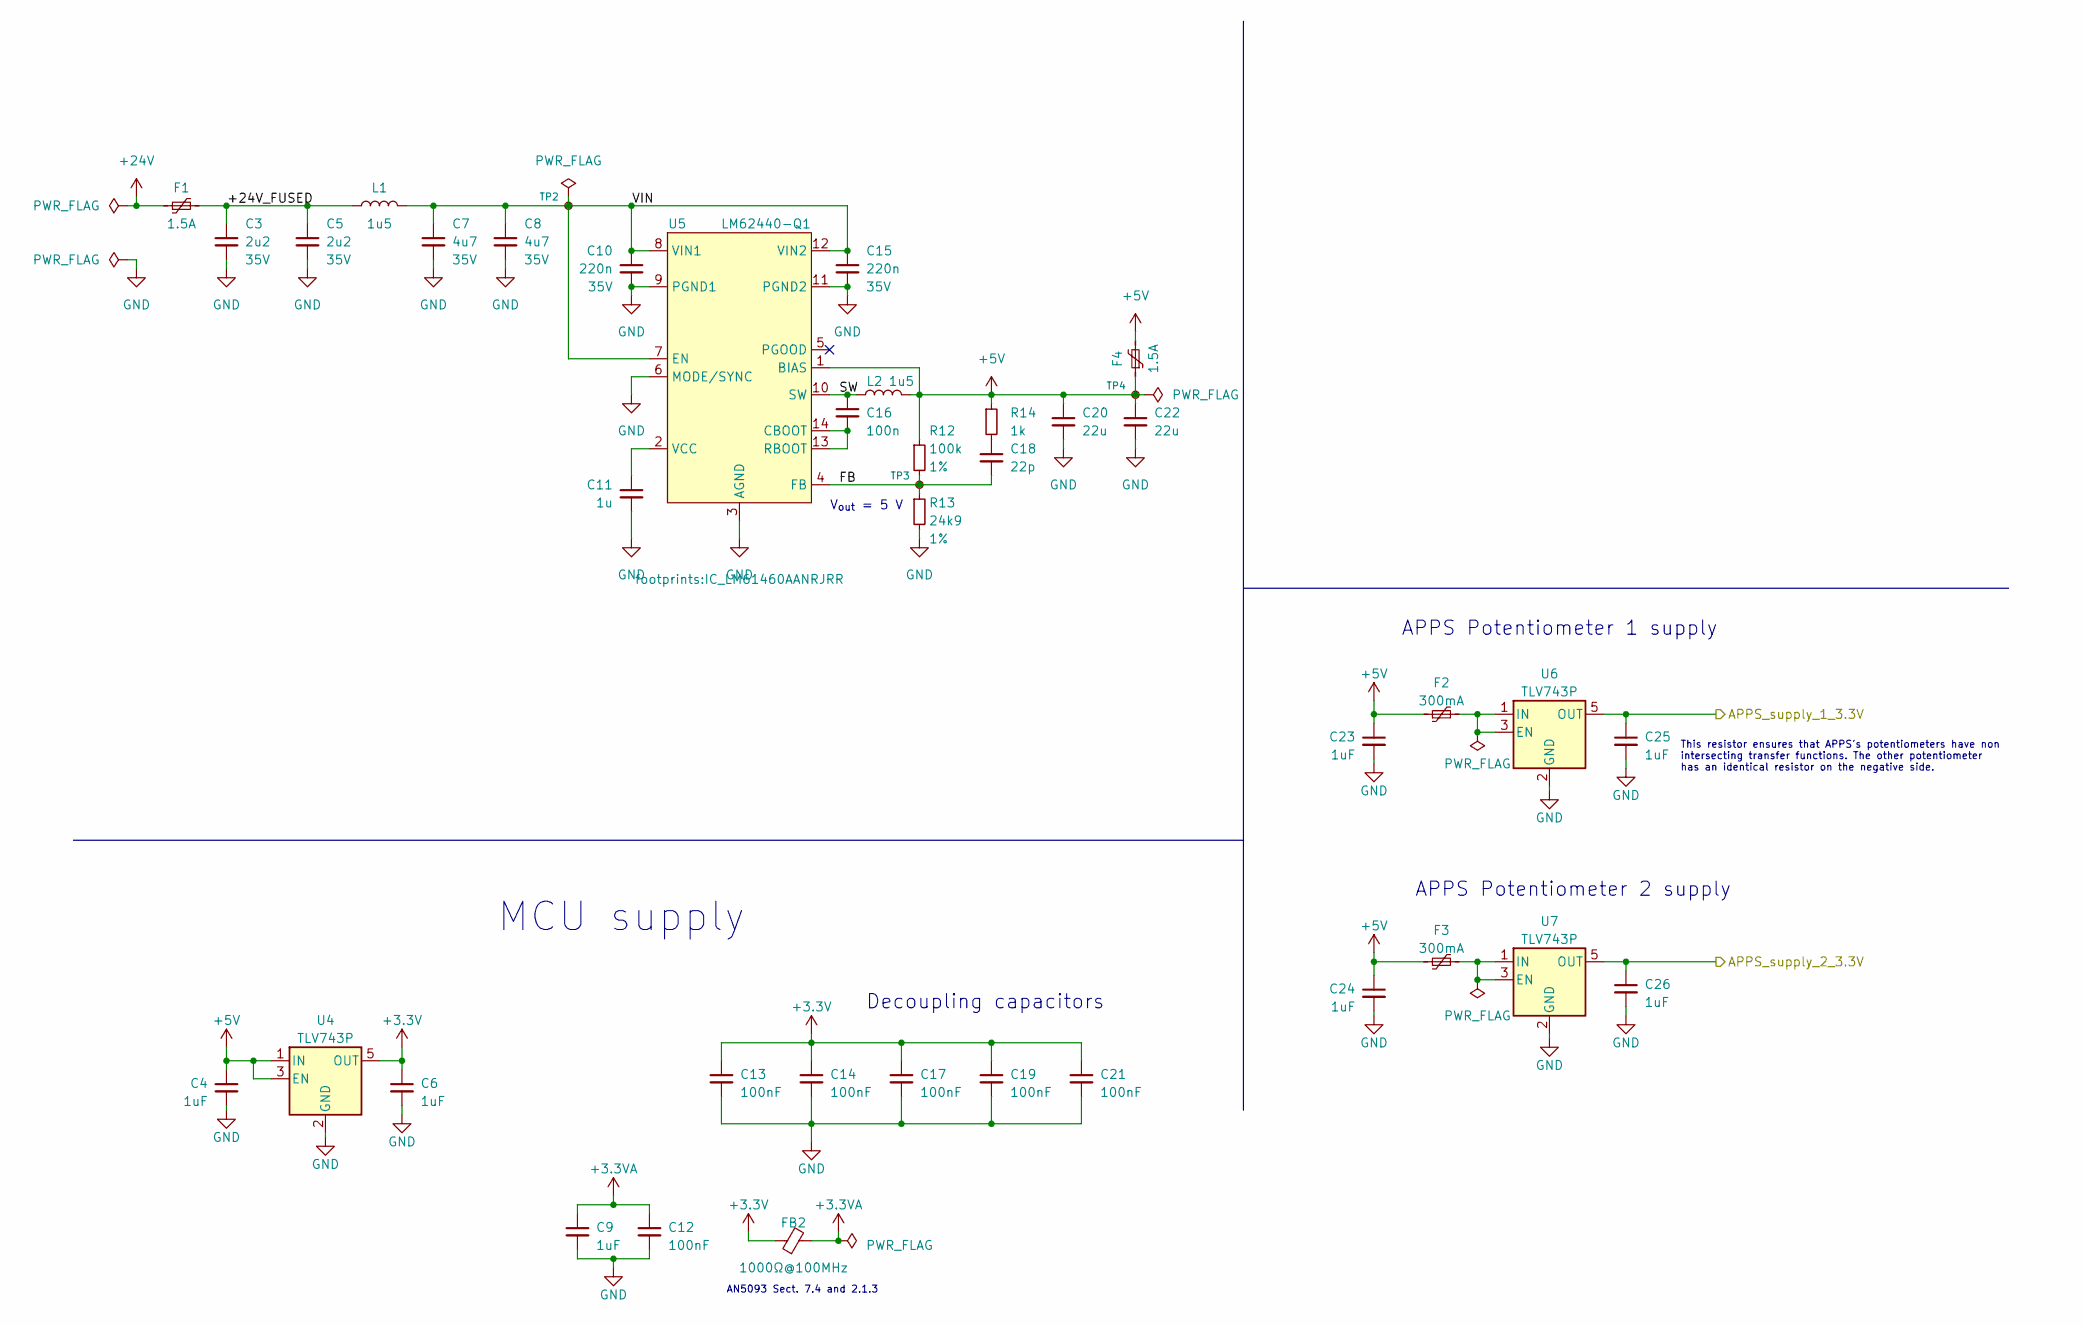
[picture p12: schematic power_section.kicad_sch, Power section]

Parts:
C3, C5: 2u2; C_0805_2012Metric; Rated Voltage 35V
C4, C6, C9, C23, C24, C25, C26: 1uF; C_0402_1005Metric_Pad0.74x0.62mm_HandSolder
C7, C8: 4u7; C_0805_2012Metric; Rated Voltage 35V
C10, C15: 220n; C_0805_2012Metric; Rated Voltage 35V
C11: 1u; C_0603_1608Metric
C12, C13, C14, C17, C19, C21: 100nF; C_0402_1005Metric_Pad0.74x0.62mm_HandSolder
C16: 100n; C_0603_1608Metric
C18: 22p; C_0603_1608Metric
C20, C22: 22u; C_0603_1608Metric
F1, F4: 1.5A; Fuse_1812_4532Metric
F2, F3: 300mA; Fuse_0603_1608Metric_Pad1.05x0.95mm_HandSolder
FB2: 1000Ω@100MHz; L_0603_1608Metric
L1, L2: 1u5; L_Abracon_ASPI-4030S
R12: 100k; R_0603_1608Metric; Tolerance 1%
R13: 24k9; R_0603_1608Metric; Tolerance 1%
R14: 1k; R_0603_1608Metric
TP2, TP3, TP4: TestPoint_Small; TestPoint_Pad_D1.0mm
U4, U6, U7: TLV743P; SOT-23-5_HandSoldering
U5: LM62440-Q1; IC_LM61460AANRJRR

Connections:
+3.3V: C6.1, C13.1, C14.1, C17.1, C19.1, C21.1, FB2.1, U4.5 (OUT); also elsewhere on the board
+3.3VA: C9.1, C12.1, FB2.2; also elsewhere on the board
+5V: C4.1, C20.1, C22.1, C23.1, C24.1, F2.1, F3.1, F4.1, F4.2, L2.2, R12.1, R14.1, TP4.1, U4.1 (IN), U4.3 (EN), U5.1 (BIAS); also elsewhere on the board
+24V: F1.1; also elsewhere on the board
/APPS1_3V3: C25.1, U6.5 (OUT); also elsewhere on the board
/APPS2_3V3: C26.1, U7.5 (OUT); also elsewhere on the board
/Power section/+24V_FUSED: C3.1, C5.1, F1.2, L1.1
/Power section/FB: C18.2, R12.2, R13.1, TP3.1, U5.4 (FB)
/Power section/SW: C16.1, L2.1, U5.10 (SW)
/Power section/VIN: C7.1, C8.1, C10.1, C15.1, L1.2, TP2.1, U5.7 (EN), U5.8 (VIN1), U5.12 (VIN2)
GND: C3.2, C4.2, C5.2, C6.2, C7.2, C8.2, C9.2, C10.2, C11.2, C12.2, C13.2, C14.2, C15.2, C17.2, C19.2, C20.2, C21.2, C22.2, C23.2, C24.2, C25.2, C26.2, R13.2, U4.2 (GND), U5.3 (AGND), U5.6 (MODE/SYNC), U5.9 (PGND1), U5.11 (PGND2), U6.2 (GND), U7.2 (GND); also elsewhere on the board
unnamed: C18.1, R14.2
unnamed: C16.2, U5.13 (RBOOT), U5.14 (CBOOT)
unnamed: C11.1, U5.2 (VCC)
unnamed: F2.2, U6.1 (IN), U6.3 (EN)
unnamed: F3.2, U7.1 (IN), U7.3 (EN)

Notes on the sheet:
APPS Potentiometer 2 supply
V_{out} = 5 V
Decoupling capacitors
AN5093 Sect. 7.4 and 2.1.3
This resistor ensures that APPS's potentiometers have non intersecting transfer functions. The other potentiometer has an identical resistor on the negative side.
APPS Potentiometer 1 supply
MCU supply

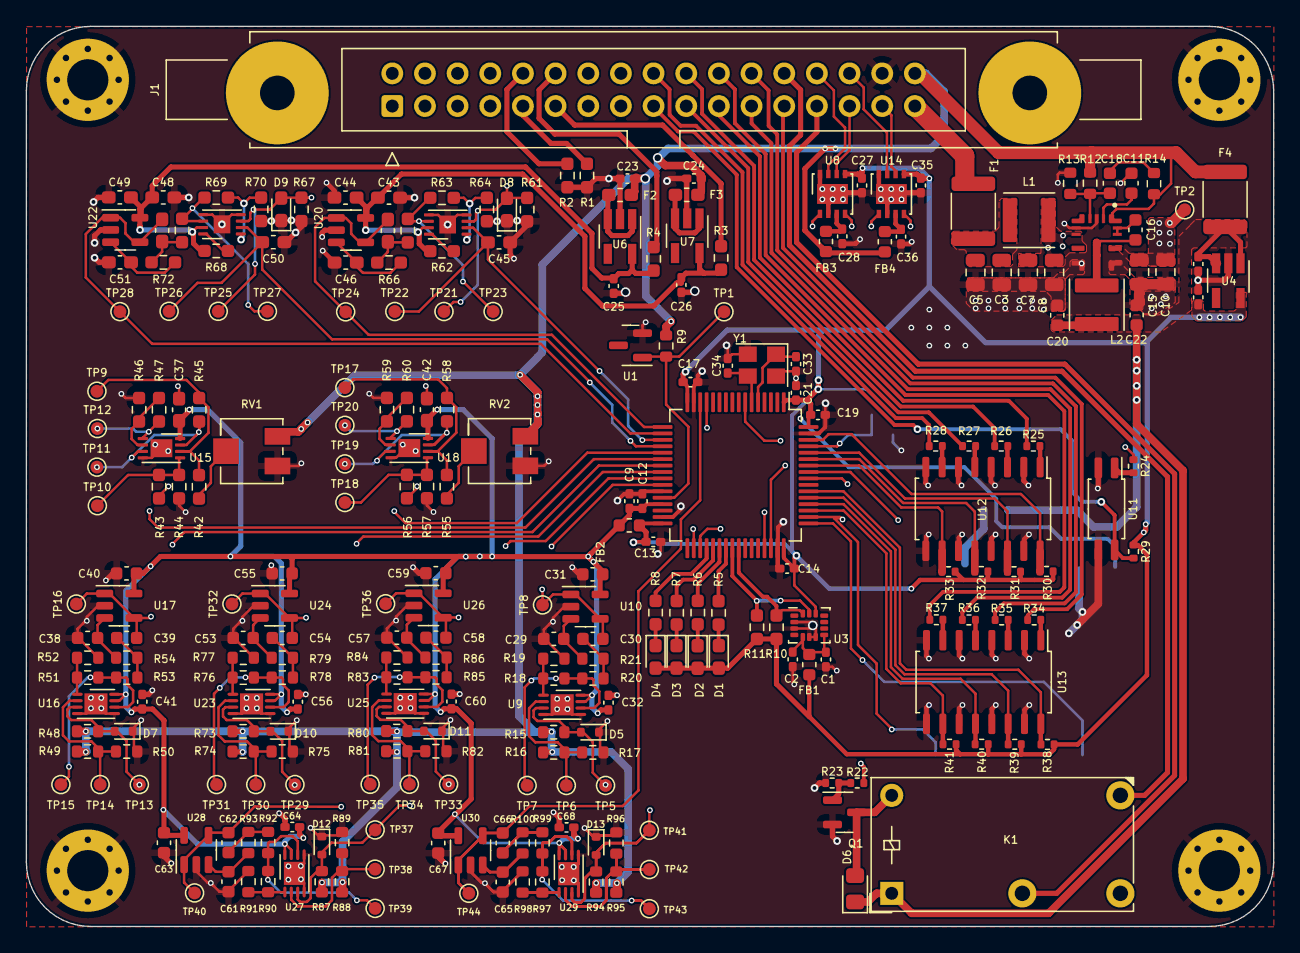
[picture p13: board PUTM_EV_Frontbox_2023.kicad_pcb from above]

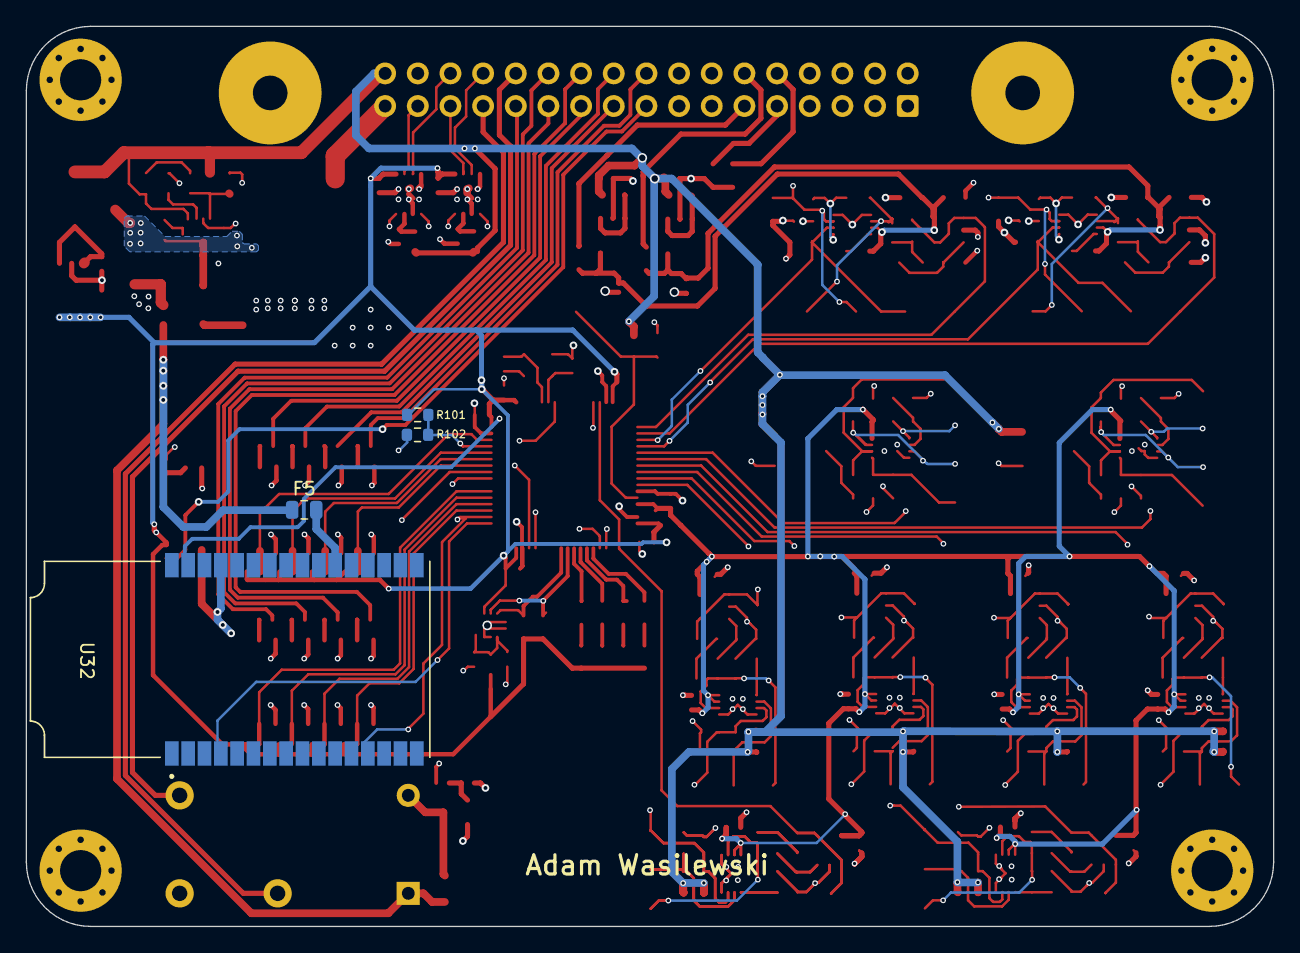
[picture p14: board PUTM_EV_Frontbox_2023.kicad_pcb from below]

Board: 4 copper layers, 97.0 x 70.0 mm, 277 parts (4 on the bottom side), 153 nets.
