PUT-Motorsport/PUTM_EV_Frontbox_2024_Hardware/(commit log)

2024-03-21 Free PB0-Boot pin
    [PUTM_EV_Frontbox_2023.kicad_pcb, PUTM_EV_Frontbox_2023.kicad_sch, programator.kicad_sch]
2024-03-22 Fixed production issues
    [PUTM_EV_Frontbox_2023.kicad_pcb, PUTM_EV_Frontbox_2023.kicad_sch, programator.kicad_sch]
2024-03-22 Fixed corners
    [PUTM_EV_Frontbox_2023.kicad_pcb]
